JojoLico/Flight-Desk-Control-Demonstrator/Flight Desk Control Demonstrator.PNG

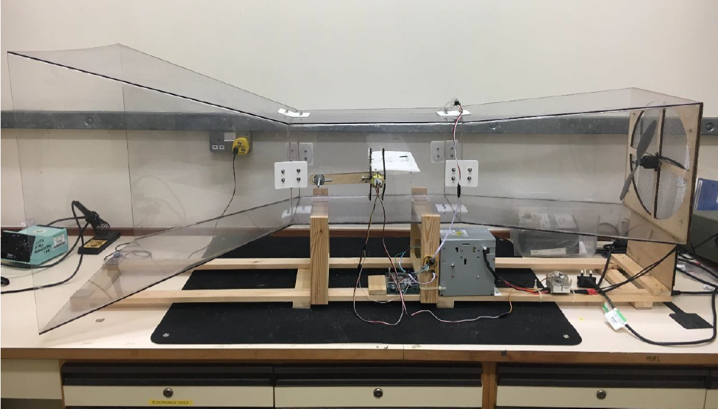
Flight Desk Control Demonstrator.PNG
