JojoLico/Flight-Desk-Control-Demonstrator/readme.txt

//--Flight Desk Control Demonstrator--//
//--------Cranfield University--------//
//-------------Version V1-------------//
//-------------Joris Duran------------//

//--------------Included--------------//

All the CAD files
All The CFD files (Aerofoil and Wind tunnel)
The Excel files for the design and the assessment of the demonstrator
The Matlab Model
The Author's Thesis
The datasheets of the electrical components
Electronic Schematics
The source code inside the controller and all the necessary code for maintenance
	Libraries
	ESC calibration
	AT command to change the settings of the Bluetooth module (HC-05)
The source code inside the controller and all the necessary code for maintenance
	Libraries
	The JAVA jdk to install to run the GUI (JAVA 8 172)
	The Dll to install (see GUI readme)
Troubleshooting

//----------Troubleshooting-----------//

Remove the Bluetooth module to connect the board via USB cable
If the motor acts weirdly, recalibrate the ESC
Re-starting the GUI fixs a lot of problem
The aerofoil zero angle is wrong, press the push-button on the PDB when the aerofoil is at the right angle
The airflow velocity is wrong, adjust the value thanks to the potentiometre on the PDB
The system response is not symmetric, the crank must be readjusted and balanced
If the motor drawn suddenly to much current the power supply turns off itself, recalibrate the ESC
The app does not start, install the right JAVA jdk version (provided)
