JojoLico/Flight-Desk-Control-Demonstrator/PID_Controller/readme.txt

//---------- PID Controller ----------//
//--------Cranfield University--------//
//-------------Version V1-------------//
//-------------Joris Duran------------//

Install the Arduino IDE
Install the Libraries
Remove the Bluetooth module to connect the USB cable
Select the rigth Port COM
Select Arduino nano
Select Atmel 328p 16Mhz Old Bootloader
Read the comments to understand the code
