JojoLico/Flight-Desk-Control-Demonstrator/GUI.PNG

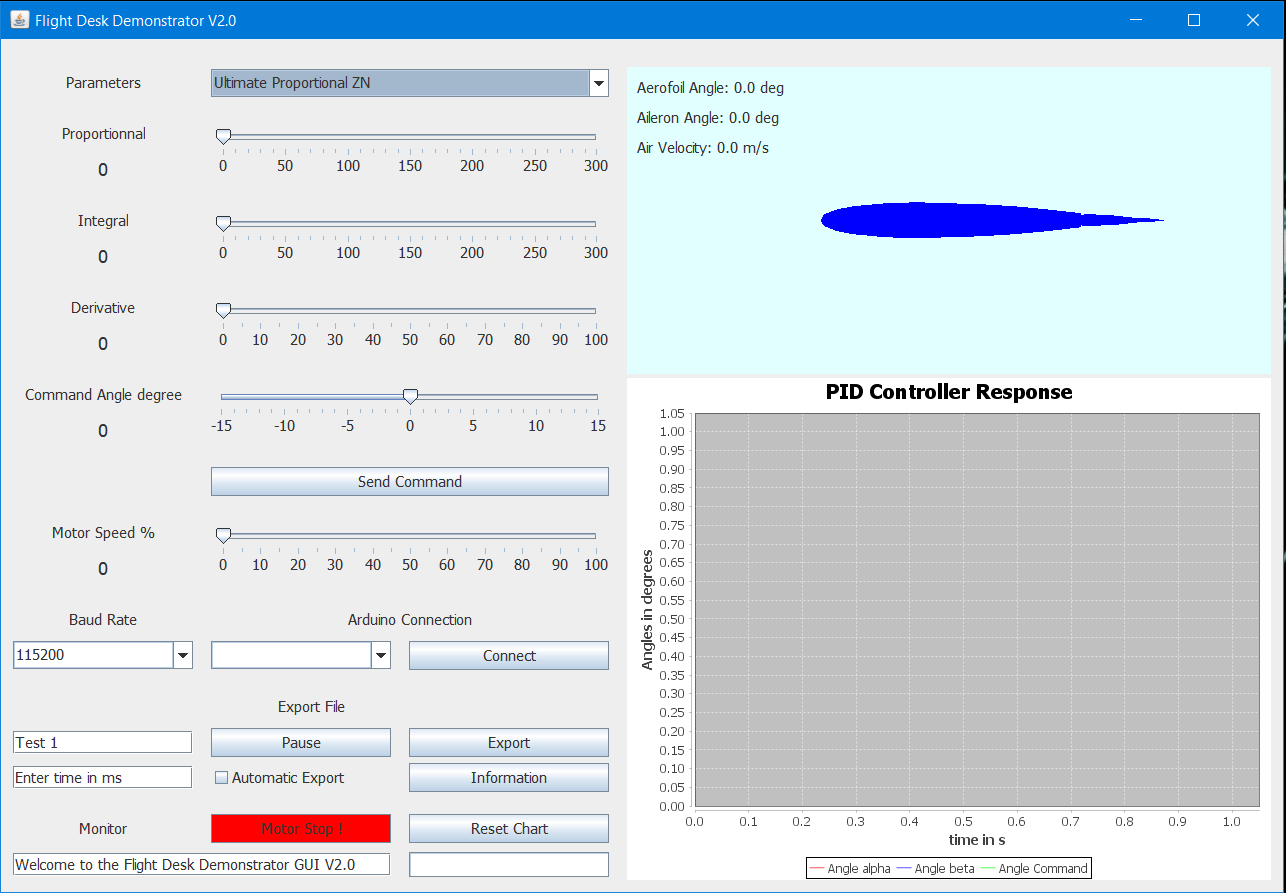
GUI.PNG
