JojoLico/Flight-Desk-Control-Demonstrator/PID_Controller/Arduino Circuit.png

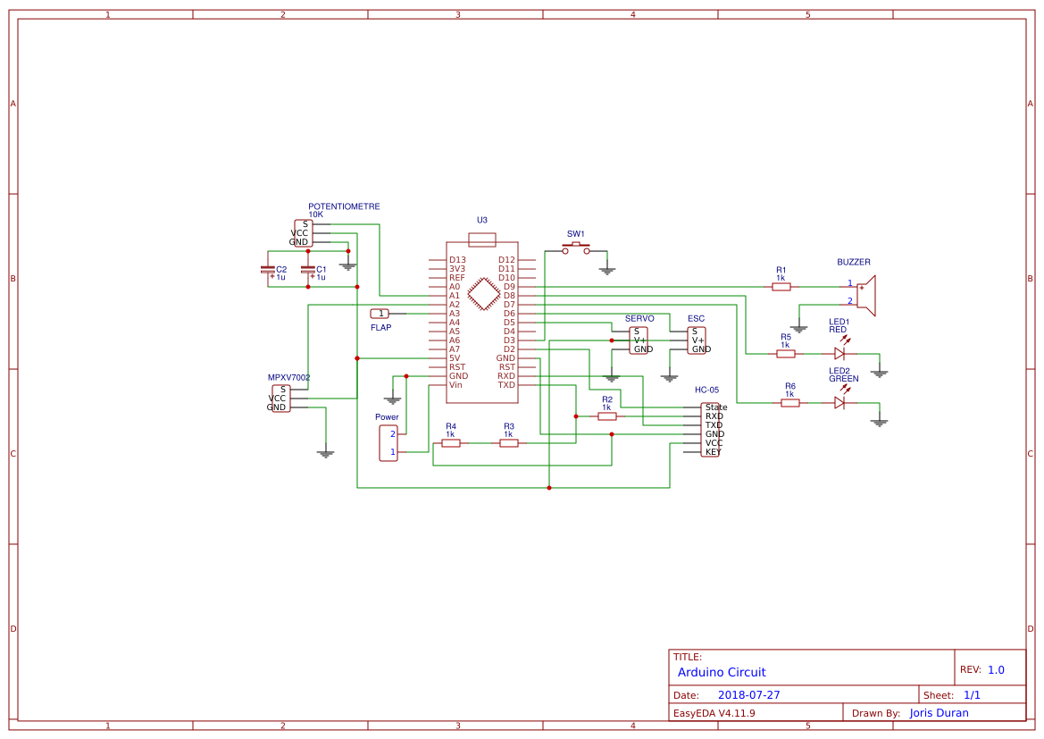
PID_Controller/Arduino Circuit.png
