JojoLico/Flight-Desk-Control-Demonstrator/PID_Controller/Pitot tube circuit.png

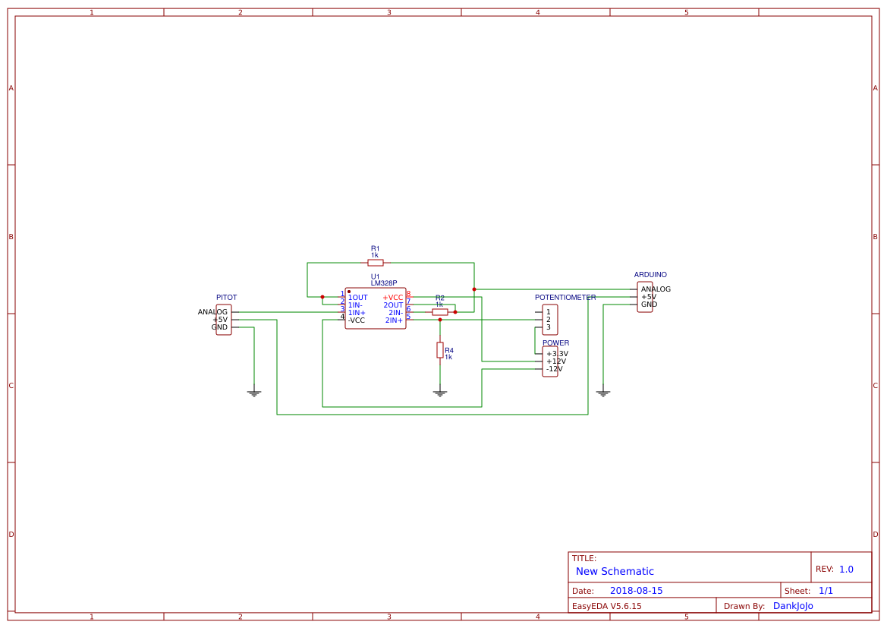
PID_Controller/Pitot tube circuit.png
